winlygit/IntelligentCar/智能车pcb/BOM_智能车驱动板_智能车驱动_2026-09-06.xlsx

No. | Quantity | Comment | Designator | Footprint | Value | Manufacturer Part | Manufacturer | Supplier Part | Supplier | 是否购买
1 | 14 | 100nF | C1,C2,C3,C5,C7,C11,C12,C20,C21,C22,C23,C24,C25,C27 | C0603 | 100nF |  |  |  |  | 1
2 | 2 | 10uF | C4,C26 | C0603 | 10uF |  |  |  |  | 1
3 | 2 | 4.7uF | C13,C14 | CAP-SMD_BD5.0-L5.3-W5.3-FD | 4.7uF | EMVE500ADA4R7ME55G | NCC(日本贵弥功) | C178270 | LCSC | 1
4 | 1 | 10nF | C15 | C0603 | 10nF |  |  |  |  | 1
5 | 2 | 100uF | C16,C17 | CAP-SMD_BD5.0-L5.3-W5.3-FD | 100uF | EMVE500ADA4R7ME55G | NCC(日本贵弥功) |  | LCSC | 1
6 | 2 | 20pF | C18,C19 | C0603 | 20pF |  |  |  |  | 1
7 | 4 | 220uF | C28,C29,C30,C31 | CAP-TH_BD6.3-P2.50-D0.6-FD-H12.0 | 220uF | PA35V220M6x12 | JIERR(捷而瑞) | C46550432 | LCSC | 1
8 | 1 | CH340K | CH340K | ESOP-10_L4.9-W3.9-P1.00-LS6.0-BL-EP |  | CH340K | WCH(南京沁恒) | C18208922 | LCSC | 1
9 | 4 | 5264-3P ZZMS | CN2,CN3,CN4,总线电机 | CONN-TH_5264-3P-ZZMS |  | 5264-3P ZZMS | SHOU HAN(首韩) | C49023814 | LCSC | 1
10 | 1 | D_1N4007 | D1 | SMA_1N4007 |  |  |  |  |  | 1
11 | 1 | TPS5450QDDARQ1 | DC | SOIC-8_L4.9-W3.9-P1.27-LS6.0-BL-EP |  | TPS5450QDDARQ1 | TI(德州仪器) | C181270 | LCSC | 1
12 | 6 | LAIL-PZ2.54-3P-L | DJ0,DJ1,DJ2,DJ3,DJ4,DJ5 | HDR-TH_3P-P2.54-V-M-1 |  | LAIL-PZ2.54-3P-L | LAILAN(莱联) | C54950604 | LCSC | 1
13 | 1 | LAIL-PM2.54-4P-L | IIC1 | HDR-TH_4P-P2.54-V-F |  | LAIL-PM2.54-4P-L | LAILAN(莱联) | C54973823 | LCSC | 1
14 | 1 | 15uH | L2 | IND-SMD_L7.3-W6.6 |  | 15uH |  | C9900022584 | LCSC | 1
15 | 1 | AMS1117-3.3 | LDO | SOT-223-3_L6.5-W3.4-P2.30-LS7.0-BR |  | AMS1117-3.3 | AMS | C6186 | LCSC | 1
16 | 2 | LED_0603-G | LED3.3,LED5 | LED_0603 |  |  |  |  |  | 1
17 | 1 | LAIL-PHC2.54-4P-01-XH-L | OPENMV | CONN-TH_LAIL-PHC2.54-4P-01-XH-L |  | LAIL-PHC2.54-4P-01-XH-L | 莱联 | C54905972 | LCSC | 1
18 | 1 | WJ500V-5.08-2P电源接线端子 | P1 | CONN-TH_2P-P5.00_WJ500V-5.08-2P |  | WJ500V-5.08-2P | KANGNEX(康奈克斯电气) | C8465 | LCSC | 1
19 | 1 | LED_0805-R | PC13 | LED_0805 |  |  |  |  |  | 1
20 | 1 | S8550_SOT_PNP | Q2 | S8550P_SOT |  |  |  |  |  | 1
21 | 1 | S8050_SOT_NPN | Q3 | S8050_SOT-23 |  |  |  |  |  | 1
22 | 2 | 5.1K | R1,R2 | R0603 | 5.1K |  |  |  |  | 1
23 | 2 | 4.7K | R3,R4 | R0603 | 4.7K |  |  |  |  | 1
24 | 5 | 10K | R9,R10,R13,R16,R18 | R0603 | 10K |  |  |  |  | 1
25 | 3 | 2K | R11,R12,R22 | R0603 | 2K |  |  |  |  | 1
26 | 1 | 3.16K | R14 | R0603 | 3.16K |  |  |  |  | 1
27 | 3 | 1K | R17,R19,R20 | R0603 | 1K |  |  |  |  | 1
28 | 1 | 5K | R21 | R0603 | 5K |  |  |  |  | 1
29 | 1 | TS-1101-C-W | RST | SW-SMD_L6.0-W3.3-LS8.0_TS-1101-C-W |  | TS-1101-C-W | XKB Connection(中国星坤) | C318938 | LCSC | 1
30 | 4 | M3螺丝 | SCREW1,SCREW2,SCREW3,SCREW4 | M3螺丝 |  |  |  |  |  | 1
31 | 2 | LAIL-PZ2.54-4P-L | STLINK,串口5 | CONN-TH_LAIL-PZ2.54-4P-L |  | LAIL-PZ2.54-4P-L | 莱联 | C54950602 | LCSC | 1
32 | 1 | STM32F103RCT6 | STM32F103RCT6 | LQFP-64_L10.0-W10.0-P0.50-LS12.0-BL |  | STM32F103RCT6 | ST(意法半导体) | C8323 | LCSC | 1
33 | 1 | SN74HC126DRE4 | U1 | SOIC-14_L8.7-W3.9-P1.27-LS6.0-BL |  | SN74HC126DRE4 | TI(德州仪器) | C2676174 | LCSC | 1
34 | 2 | SS54 | U2,U14 | SMA_L4.2-W2.6-LS5.1-RD |  | SS54 |  | C9900023219 | LCSC | 1
35 | 1 | SS12D10G5电源开关 | U4 | SW-TH_SHOU-HAN_SS12D10G4 |  | SS12D10G5 | SHOU HAN(首韩) | C7431054 | LCSC | 1
36 | 1 | 晶振,SMD-8M-20PF-20PPM,3225,ROHS | U9 | CRYSTAL-SMD_4P-L3.2-W2.5-BL |  | 晶振,SMD-8M-20PF-20PPM,3225,ROHS |  | C9900015106 | LCSC | 1
37 | 1 | W25Q64FVSSIG | W25Q64 | SOP-8_L5.3-W5.2-P1.27-LS7.9-BL |  | W25Q64FVSSIG |  | C14067 | LCSC | 1
38 | 1 | typec | 串口1 | USB-C-SMD_KH-TYPE-C-16P |  | typec |  | C9900016956 | LCSC | 1
39 | 1 | 5Pin | 蓝牙串口 | HDR-TH_5P-P2.54-V-F-B |  | 5Pin | LAILAN(莱联) | C54973829 | LCSC | 1
40 | 1 | XH-4A | 超声波 | CONN-TH_XH2.50-4P |  | XH-4A | HCTL(华灿天禄) | C2908602 | LCSC | 1
