winlygit/IntelligentCar/智能车pcb/智能车pcb原理图.pdf

电源输入电路 | 滤波电路

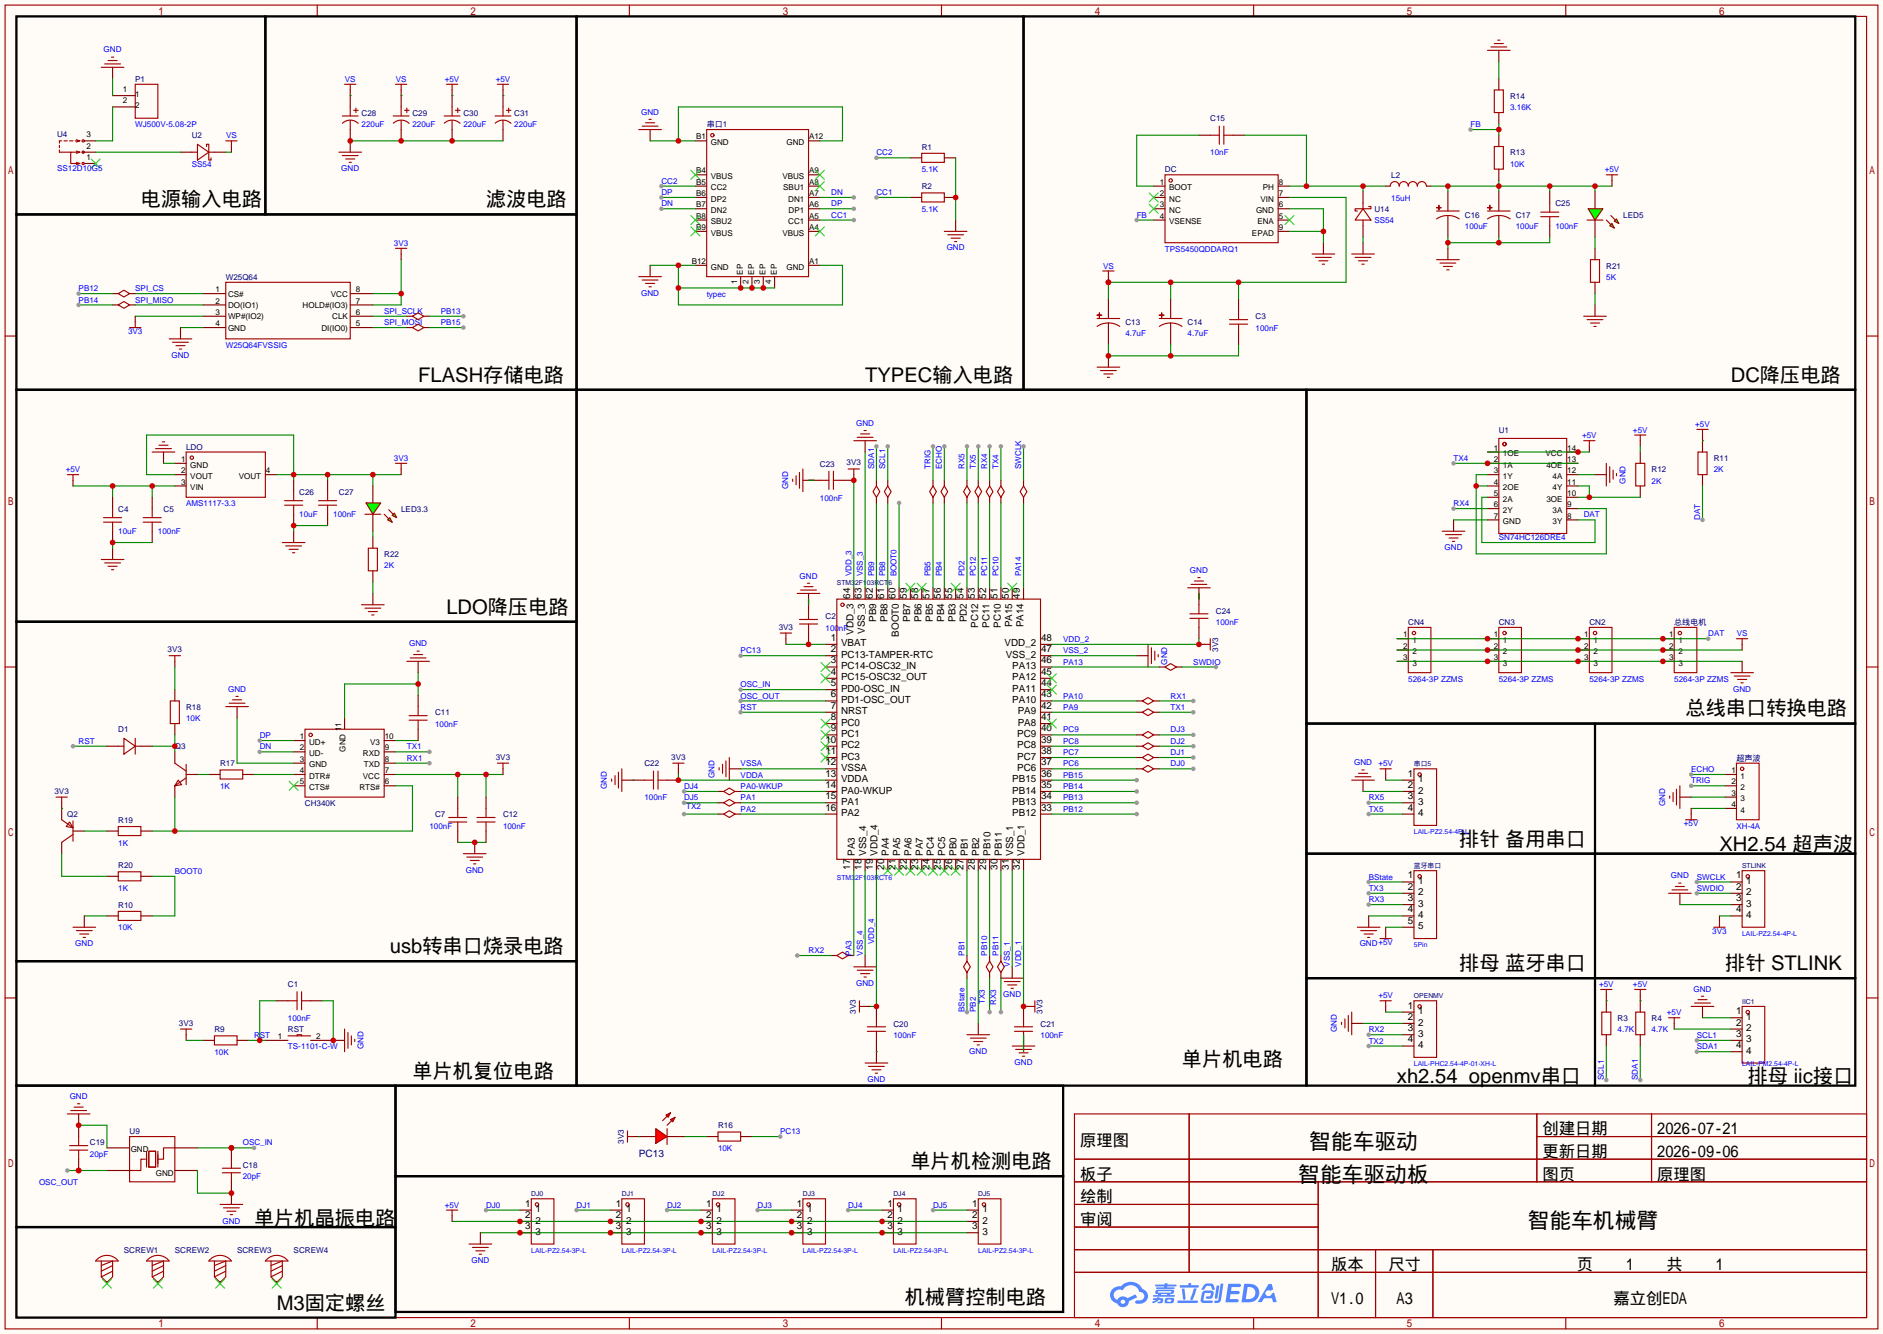
[picture p1: page 1]

BOOT0
PB12 33 PB13 34 PB14 35 PB15 36 PC6 37 PC7 38 PC8 39 PC9 40 PA8 41 PA9 42 PA10 43 PA11 44 PA12 45 PA13 46 VSS_2 47 VDD_2 48 PA¹⁴ ⁴⁹ PA¹⁵ ⁵⁰

原理图 | 智能车驱动 | 创建日期 | 2026-07-21

更新日期 | 2026-09-06

板子 | 智能车驱动板 | 图页 | 原理图
绘制 | | 智能车机械臂
审阅

V1.0 | A3 | 嘉立创EDA
