winlygit/IntelligentCar/Core/Src/main.c

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
/* Includes ------------------------------------------------------------------*/
#include "main.h"

/* USER CODE BEGIN Includes */
#include <stdio.h>
#include <string.h>
#include "global.h"
#include "uart.h"
#include "readdata.h"
#include "ik.h"
#include "motor.h"
#include "led.h"
#include "servo.h"
#include "mode.h"
#include "ag_config.h"
#include "actiongroup.h"
#include "flash.h"
#include "ultrasonic.h"
/* USER CODE END Includes */

I2C_HandleTypeDef hi2c1;

SPI_HandleTypeDef hspi2;

TIM_HandleTypeDef htim2;
TIM_HandleTypeDef htim3;
TIM_HandleTypeDef htim4;
TIM_HandleTypeDef htim8;

UART_HandleTypeDef huart4;
UART_HandleTypeDef huart5;
UART_HandleTypeDef huart1;
UART_HandleTypeDef huart2;
UART_HandleTypeDef huart3;

void SystemClock_Config(void);
static void MX_GPIO_Init(void);
static void MX_I2C1_Init(void);
static void MX_SPI2_Init(void);
static void MX_TIM2_Init(void);
static void MX_TIM3_Init(void);
static void MX_TIM8_Init(void);
static void MX_UART4_Init(void);
static void MX_UART5_Init(void);
static void MX_USART1_UART_Init(void);
static void MX_USART2_UART_Init(void);
static void MX_USART3_UART_Init(void);
static void MX_TIM4_Init(void);
/**
  * @brief  The application entry point.
  * @retval int
  */
int main(void)
{

  /* USER CODE BEGIN 1 */
 MODE mode;
  /* USER CODE END 1 */

  /* MCU Configuration--------------------------------------------------------*/

  /* Reset of all peripherals, Initializes the Flash interface and the Systick. */
  HAL_Init();

  /* Configure the system clock */
  SystemClock_Config();

  /* Initialize all configured peripherals */
  MX_GPIO_Init();
  MX_I2C1_Init();
  MX_SPI2_Init();
  MX_TIM2_Init();
  MX_TIM3_Init();
  MX_TIM8_Init();
  MX_UART4_Init();
  MX_UART5_Init();
  MX_USART1_UART_Init();
  MX_USART2_UART_Init();
  MX_USART3_UART_Init();
  MX_TIM4_Init();
  /* USER CODE BEGIN 2 */
  uart_init();
	servo_init();
  ActionGroup_Init();
  Ultrasonic_Init();
  /* USER CODE END 2 */

  /* Infinite loop */
  /* USER CODE BEGIN WHILE */
  while (1)
  {
    if(rxcplt_flag_Phone == 1){
          mode = readmode(RxData_Phone);
          rxcplt_flag_Phone = 0;
          ifrxstart_Phone = 0;
          
          switch (mode) {
              case mode1:
                  mode1_handle();
                  break;
              case mode2:
                  mode2_handle();
                  break;
              case mode3:
                  mode3_handle();
                  break;
              case mode4:
                  mode4_handle();
                  break;
              default:
                  break;
          }
      }
    /* USER CODE END WHILE */

    /* USER CODE BEGIN 3 */
  }
  /* USER CODE END 3 */
}

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
/* USER CODE BEGIN 4 */
//  void HAL_GPIO_EXTI_Callback(uint16_t GPIO_Pin){//蓝牙断联处理
//  if(GPIO_Pin == GPIO_PIN_8){
//        servo_init();
//      motorspeed.LBsd = 0;
//      motorspeed.LFsd = 0;
//      motorspeed.RBsd = 0;
//      motorspeed.RFsd = 0;
//      SendmotorCmd();
//  }
//}
/* USER CODE END 4 */
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
