winlygit/IntelligentCar/User/actiongroup.c

/*  
本文件用于动作组函数存放，如播放录制整理
                                     */

#include "actiongroup.h"
#include "ag_config.h"
#include "flash.h"
#include "global.h"
#include "motor.h"
#include "servo.h"
#include <string.h>
#include <stdio.h>
#include "uart.h"
#include "ik.h"

/***********全局变量************/

ActionGroupHeader_t hdr;

volatile int recording_active = 0;      // 表示现在是不是正在录制，1=是，0=不是
uint16_t rec_group_id = 0;              // 当前录制的动作组ID
volatile uint16_t rec_step_count = 0;   // 当前录了多少步了
volatile uint32_t rec_total_time_ms = 0;// 当前录制的总时长


static uint32_t rec_addr;               // 当前录制开始的扇区地址
static char rec_name[16];               // 当前录制的动作组名字
static uint32_t last_rec_tick = 0;      // 上一次采样时的时间戳


static uint8_t sector_buf[SECTOR_SIZE]; //碎片整理时临时搬数据用的

/* RAM录制缓冲区，大小由MAX_TOTAL_STEPS决定，就是先存这里 */
static ActionStep_t rec_buffer[MAX_TOTAL_STEPS];

// 计算一个动作组要占几个扇区，（向上取整）
uint16_t ActionGroup_SectorCount(ActionGroupHeader_t *hdr)
{
    uint32_t data_size = sizeof(ActionGroupHeader_t) + hdr->step_count * sizeof(ActionStep_t);
    uint16_t sectors = (uint16_t)((data_size + SECTOR_SIZE - 1) / SECTOR_SIZE);
    return sectors;
}


/****************动作组初始化*****************/
void ActionGroup_Init(void)
{
    ActionConfig_Init();    // 初始化配置（读取/重建）
    recording_active = 0;   // 确保不在录制状态
}


/****************动作组录制相关*****************/
int ActionGroup_StartRecord(const char *name, uint8_t name_len)
{
    if (recording_active) {
        return -1; // 已经在录了，不能再开
    }

    // 计算一个动作组最多可能占多少扇区
    uint16_t max_sectors = (uint16_t)((sizeof(ActionGroupHeader_t) +MAX_TOTAL_STEPS * sizeof(ActionStep_t) + SECTOR_SIZE - 1) / SECTOR_SIZE);
    // 获取当前空闲地址
    uint32_t free_addr = ActionConfig_GetFreeSector();
    // 空间不够则先整理碎片
    if (free_addr + max_sectors * SECTOR_SIZE > RECORD_END) {
        ActionGroup_Defrag();
        free_addr = ActionConfig_GetFreeSector();
        if (free_addr + max_sectors * SECTOR_SIZE > RECORD_END) {
            return -1;
        }
    }

    rec_addr = free_addr;
    rec_group_id = ActionConfig_GetNextGroupID(); // 分配ID

    // 清空名字，再拷贝进去
    memset(rec_name, 0, sizeof(rec_name));
    if (name_len > 15) {
        name_len = 15; // 名字最长15个字符
    }
    memcpy(rec_name, name, name_len);

    // 先擦掉后面3个扇区，防止原来有数据影响（3个？
    // for (uint16_t s = 0; s < max_sectors; s++) {
    //     W25Q_SectorErase(rec_addr + s * SECTOR_SIZE);
    // }

    rec_step_count = 0;        //步数清零
    rec_total_time_ms = 0;     // 总时间清零
    last_rec_tick = HAL_GetTick(); //   记录一下开始时间
    recording_active = 1;      //设置录制中标志

    return 0;
}

void ActionGroup_StopRecord(void)
{
    if (!recording_active) {
        return; //没在录，直接返回
    }
    recording_active = 0; //关掉标志

    uint16_t steps = rec_step_count; //实际录了多少步

    //计算实际需要几个扇区
    uint16_t sectors_needed = (uint16_t)((sizeof(ActionGroupHeader_t) +steps * sizeof(ActionStep_t) + SECTOR_SIZE - 1) / SECTOR_SIZE);
    if (sectors_needed == 0) {
        sectors_needed = 1; // 至少1个扇区，用来放头部
    }

    // 把除了第一个扇区以外的其他扇区擦掉
    for (uint16_t s = 0; s < sectors_needed; s++) {
        W25Q_SectorErase(rec_addr + s * SECTOR_SIZE);
    }

    //头部信息
    ActionGroupHeader_t hdr;
    memset(&hdr, 0, sizeof(hdr));
    hdr.magic[0] = 0xAA;
    hdr.magic[1] = 0x55;
    hdr.group_id = rec_group_id;
    strncpy(hdr.name, rec_name, 16);
    hdr.step_count = steps;
    hdr.total_time_ms = rec_total_time_ms;

    // 写头部
    W25Q_WriteData(rec_addr, (uint8_t *)&hdr, sizeof(hdr));

    // 如果有步骤数据，就把RAM缓冲区的数据一次性写进去
    if (steps > 0) {
        uint32_t offset = rec_addr + sizeof(ActionGroupHeader_t);
        uint32_t size = steps * sizeof(ActionStep_t);
        W25Q_WriteData(offset, (uint8_t *)rec_buffer, size);
    }

    // 更新配置：空闲地址后移实际使用的扇区数
    uint32_t new_free = rec_addr + sectors_needed * SECTOR_SIZE;
    uint16_t new_id = rec_group_id + 1;
    ActionConfig_Update(new_free, new_id);
}

void ActionGroup_RecordStep(const servoANGLE *servoangle)
{
    if (!recording_active) return;
    if (rec_step_count >= MAX_TOTAL_STEPS) {
        ActionGroup_StopRecord();
        return;
    }

    ActionStep_t *step = &rec_buffer[rec_step_count];
    step->joint[0] = servoangle->D1;
    step->joint[1] = servoangle->D2;
    step->joint[2] = servoangle->D3;
    step->joint[3] = servoangle->D4;
    step->joint[4] = servoangle->D5;
    step->joint[5] = servoangle->D6;

    uint32_t now = HAL_GetTick();
    step->duration_ms = now - last_rec_tick;
    last_rec_tick = now;
    rec_step_count++;
    rec_total_time_ms += step->duration_ms;
}

int ActionGroup_IsRecording(void)
{
    return recording_active;
}

/****************动作组查找、删除、列表*****************/
int ActionGroup_Find(uint16_t id, uint32_t *addr)
{
    uint32_t scan = 0;
    uint32_t tail = ActionConfig_GetFreeSector();

    while (scan < tail) {
        uint8_t magic[2];
        W25Q_ReadData(scan, magic, 2);

        if (magic[0] == 0xAA && magic[1] == 0x55) {
            ActionGroupHeader_t hdr;
            W25Q_ReadData(scan, (uint8_t *)&hdr, sizeof(hdr));

            if (hdr.group_id == id) {
                *addr = scan;
                return 1;
            }

            uint16_t sectors = ActionGroup_SectorCount(&hdr);
            scan += sectors * SECTOR_SIZE;
        } else {
            scan += SECTOR_SIZE;
        }
    }

    return 0;
}

int ActionGroup_Delete(uint16_t id)
{
    uint32_t addr;

    if (ActionGroup_Find(id, &addr)) {
        ActionGroupHeader_t hdr;
        W25Q_ReadData(addr, (uint8_t *)&hdr, sizeof(hdr));
        uint16_t sectors = ActionGroup_SectorCount(&hdr);

        for (uint16_t s = 0; s < sectors; s++) {
            W25Q_SectorErase(addr + s * SECTOR_SIZE);
        }

        ActionGroup_Defrag(); // 删除后整理
        return 1;
    }

    return 0;
}

void ActionGroup_List_3(void)
{
    uint32_t tail = ActionConfig_GetFreeSector();
    uint16_t count = 0;
    uint32_t scan = 0;

    // 第一次扫描：统计动作组个数                         
    while (scan < tail) {
        uint8_t magic[2];
        W25Q_ReadData(scan, magic, 2);
        if (magic[0] == 0xAA && magic[1] == 0x55) {
            count++;
            ActionGroupHeader_t hdr;
            W25Q_ReadData(scan, (uint8_t *)&hdr, sizeof(hdr));
            uint16_t sectors = ActionGroup_SectorCount(&hdr);
            scan += sectors * SECTOR_SIZE;
        } else {
            scan += SECTOR_SIZE;
        }
    } 

    // 发送帧头 @M3+个数
    char header[16];
    sprintf(header, "@M3%02d", count);
    U3_printf((uint8_t*)header);

    // 第二次扫描：发送每个动作组
    scan = 0;
    while (scan < tail) {
        uint8_t magic[2];
        W25Q_ReadData(scan, magic, 2);
        if (magic[0] == 0xAA && magic[1] == 0x55) {
            ActionGroupHeader_t hdr;
            W25Q_ReadData(scan, (uint8_t *)&hdr, sizeof(hdr));

            // 计算名称实际长度（到 '\0' 为止）
            int name_len = 0;
            while (name_len < 16 && hdr.name[name_len] != '\0') {
                name_len++;
            }

            char item[32];
            sprintf(item, "\"%02d%s\"", hdr.group_id,hdr.name);   //注意格式，编号和名称的位数
            U3_printf((uint8_t*)item);

            uint16_t sectors = ActionGroup_SectorCount(&hdr);
            scan += sectors * SECTOR_SIZE;
        } else {
            scan += SECTOR_SIZE;
        }
    }

    // 发送帧尾
    U3_printf((uint8_t*)"#");
}

void ActionGroup_List_4(void)
{
    uint32_t tail = ActionConfig_GetFreeSector();
    uint16_t count = 0;
    uint32_t scan = 0;

    // 第一次扫描：统计动作组个数                         
    while (scan < tail) {
        uint8_t magic[2];
        W25Q_ReadData(scan, magic, 2);
        if (magic[0] == 0xAA && magic[1] == 0x55) {
            count++;
            ActionGroupHeader_t hdr;
            W25Q_ReadData(scan, (uint8_t *)&hdr, sizeof(hdr));
            uint16_t sectors = ActionGroup_SectorCount(&hdr);
            scan += sectors * SECTOR_SIZE;
        } else {
            scan += SECTOR_SIZE;
        }
    } 

    // 发送帧头 @M4+个数
    char header[16];
    sprintf(header, "@M4%02d", count);
    U3_printf((uint8_t*)header);

    // 第二次扫描：发送每个动作组
    scan = 0;
    while (scan < tail) {
        uint8_t magic[2];
        W25Q_ReadData(scan, magic, 2);
        if (magic[0] == 0xAA && magic[1] == 0x55) {
            ActionGroupHeader_t hdr;
            W25Q_ReadData(scan, (uint8_t *)&hdr, sizeof(hdr));

            // 计算名称实际长度（到 '\0' 为止）
            int name_len = 0;
            while (name_len < 16 && hdr.name[name_len] != '\0') {
                name_len++;
            }

            char item[32];
            sprintf(item, "\"%02d%s\"", hdr.group_id,hdr.name);   //注意格式，编号和名称的位数
            U3_printf((uint8_t*)item);

            uint16_t sectors = ActionGroup_SectorCount(&hdr);
            scan += sectors * SECTOR_SIZE;
        } else {
            scan += SECTOR_SIZE;
        }
    }

    // 发送帧尾
    U3_printf((uint8_t*)"#");
}
/****************碎片整理*****************/
void ActionGroup_Defrag(void)
{
    uint32_t read_addr = 0;
    uint32_t write_addr = 0;
    uint32_t tail = ActionConfig_GetFreeSector();
    uint16_t new_id = 1;  //新编号从 1 开始

    while (read_addr < tail) {
        uint8_t magic[2];
        W25Q_ReadData(read_addr, magic, 2);

        //跳过非动作组区域
        if (magic[0] != 0xAA || magic[1] != 0x55) {
            read_addr += SECTOR_SIZE;
            continue;
        }

        // 读取原始头部
        ActionGroupHeader_t hdr_orig;
        W25Q_ReadData(read_addr, (uint8_t *)&hdr_orig, sizeof(hdr_orig));
        uint16_t sectors = ActionGroup_SectorCount(&hdr_orig);
        // 准备新头部（仅修改 ID）
        ActionGroupHeader_t hdr_new = hdr_orig;
        hdr_new.group_id = new_id;

        if (read_addr != write_addr) {
            // 需要搬移所有扇区
            for (uint16_t s = 0; s < sectors; s++) {
                uint32_t src = read_addr + s * SECTOR_SIZE; //source地址
                uint32_t dst = write_addr + s * SECTOR_SIZE; // destination地址

                W25Q_ReadData(src, sector_buf, SECTOR_SIZE);

                // 第一个扇区：用新头部覆盖缓冲区中的头部区域
                if (s == 0) {
                    memcpy(sector_buf, &hdr_new, sizeof(hdr_new));
                }

                W25Q_SectorErase(dst);
                W25Q_WriteData(dst, sector_buf, SECTOR_SIZE);
                W25Q_SectorErase(src);
            }
        } else {
            //若原位，只需更新 ID
            if (hdr_orig.group_id != new_id) {
                W25Q_ReadData(read_addr, sector_buf, SECTOR_SIZE);
                memcpy(sector_buf, &hdr_new, sizeof(hdr_new));
                W25Q_SectorErase(read_addr);
                W25Q_WriteData(read_addr, sector_buf, SECTOR_SIZE);
            }
        }

        read_addr += sectors * SECTOR_SIZE;
        write_addr += sectors * SECTOR_SIZE;
        new_id++;
    }

    //更新配置：空闲扇区地址 + 下一个可用 ID（new_id 此时为最大 ID + 1）
    ActionConfig_Update(write_addr, new_id);
}

/****************播放*****************/

void ActionGroup_Play(uint32_t addr, servoANGLE *servoangle)
{
    W25Q_ReadData(addr, (uint8_t*)&hdr, sizeof(hdr));
    if (hdr.magic[0] != 0xAA || hdr.magic[1] != 0x55) return;

    // 播放前停止电机
    motorSPEED motorspeed;
    motor_stop(&motorspeed);
    Motor_Sendcmd(&motorspeed);
    servo_stop(servoangle);
    Servo_Sendcmd(servoangle);

    for (uint16_t i = 0; i < hdr.step_count; i++) {
        uint32_t step_start = HAL_GetTick();
        ActionStep_t step;
        W25Q_ReadData(addr + sizeof(ActionGroupHeader_t) + i * sizeof(ActionStep_t),(uint8_t*)&step, sizeof(step));

        servoangle->D1 = step.joint[0];
        servoangle->D2 = step.joint[1];
        servoangle->D3 = step.joint[2];
        servoangle->D4 = step.joint[3];
        servoangle->D5 = step.joint[4];
        servoangle->D6 = step.joint[5];

        Servo_Sendcmd(servoangle);
        uint32_t elapsed = HAL_GetTick() - step_start;
        if (elapsed < step.duration_ms) {
            HAL_Delay(step.duration_ms - elapsed);
        }
    }
    // 播放结束后停止电机和舵机
	motor_stop(&motorspeed);
    Motor_Sendcmd(&motorspeed);
    servo_stop(servoangle);
    Servo_Sendcmd(servoangle);
}
