winlygit/IntelligentCar/(commit log)

2026-05-04 编码修改为utf-8
2026-05-08 更改了.gitignore
2026-05-08 删除了多余的文件
2026-05-08 调整gitignore
2026-05-09 修改了全局变量
2026-05-11 优化代码
2026-05-12 优化了D5的处理
2026-05-12 能跑版本1
2026-08-11 数据帧读取
2026-08-26 完善mode1-3
2026-08-26 mode4和巡线
2026-08-26 修bug
2026-08-27 ack应答
2026-08-29 编译烧录测试
2026-08-29 修改数据帧读取的问题
2026-09-02 改bug改警告，还需要改的地方：1.数据帧存储格式设计。2.模式3和模式4使用两个list函数。3.模式3的删除功能回复字符串的问题解决，可以将ack回复删除放在删除完成后发送。4.多动作组，删除之后的编号顺位问题
2026-09-02 还需要改进数据帧
2026-09-03 去除电机录制
2026-09-04 删除D6
2026-09-04 修Bug2
2026-09-07 删除line，未完善通信
2026-09-07 下位机数据帧完善，串口等未修改
2026-09-11 更换芯片
    [BOM_智能车驱动板_智能车驱动_2026-09-06.xlsx]
2026-09-11 修改机械臂适配
2026-09-12 修改串口
